Flippy1212/Lernecken/Bilder/Sensor_weitwinkel.jpg

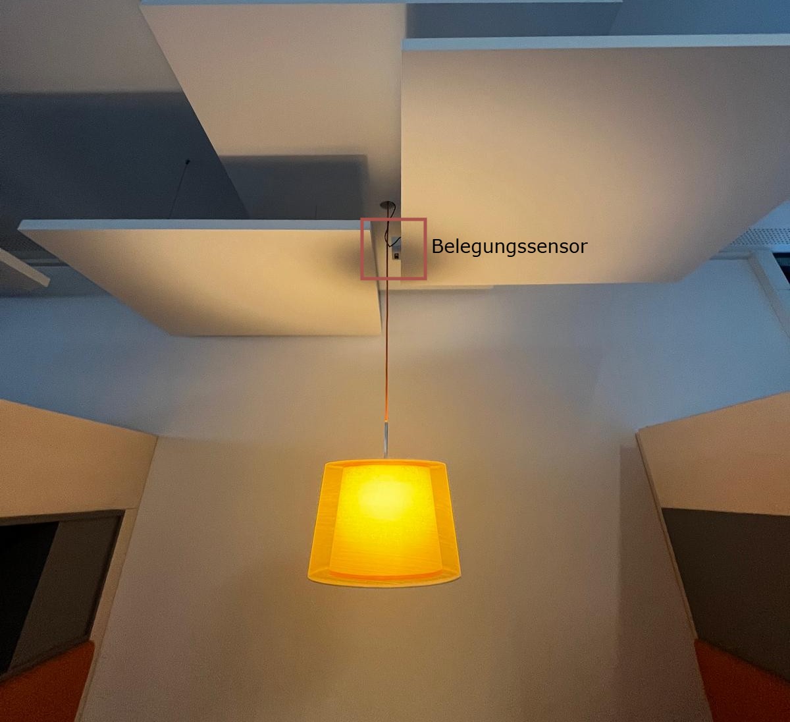
Bilder/Sensor_weitwinkel.jpg
