Flippy1212/Lernecken/Bilder/belegungserkennung_zustandsdiagramm_v12.png

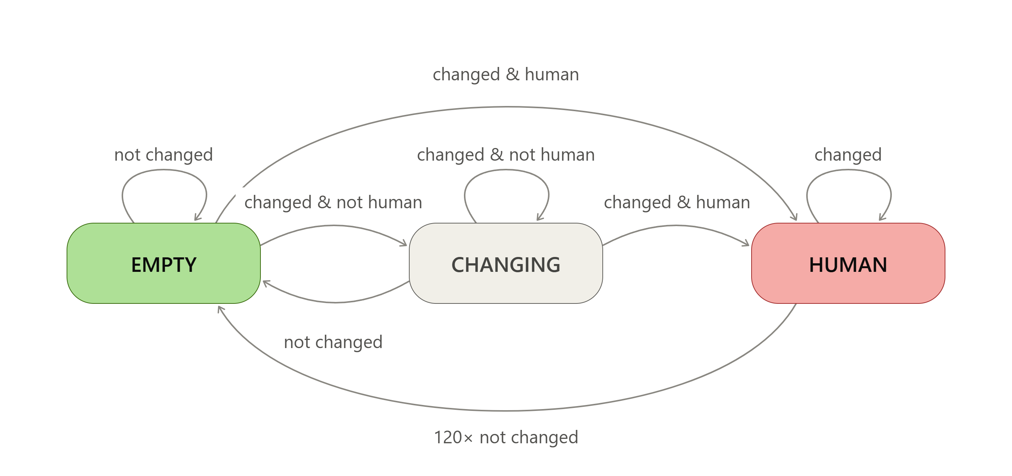
Bilder/belegungserkennung_zustandsdiagramm_v12.png
