Flippy1212/Lernecken/Bilder/heltec_v3_amg8833_verdrahtung.jpg

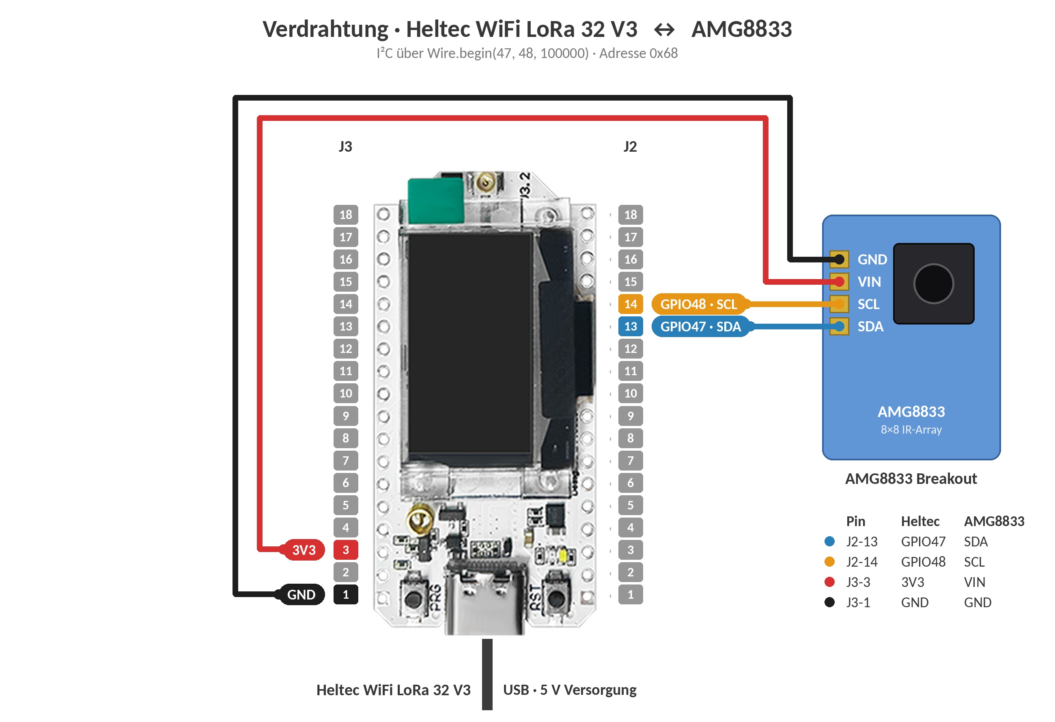
Bilder/heltec_v3_amg8833_verdrahtung.jpg
