Flippy1212/Lernecken/Lerneckenbox/Box.3mf

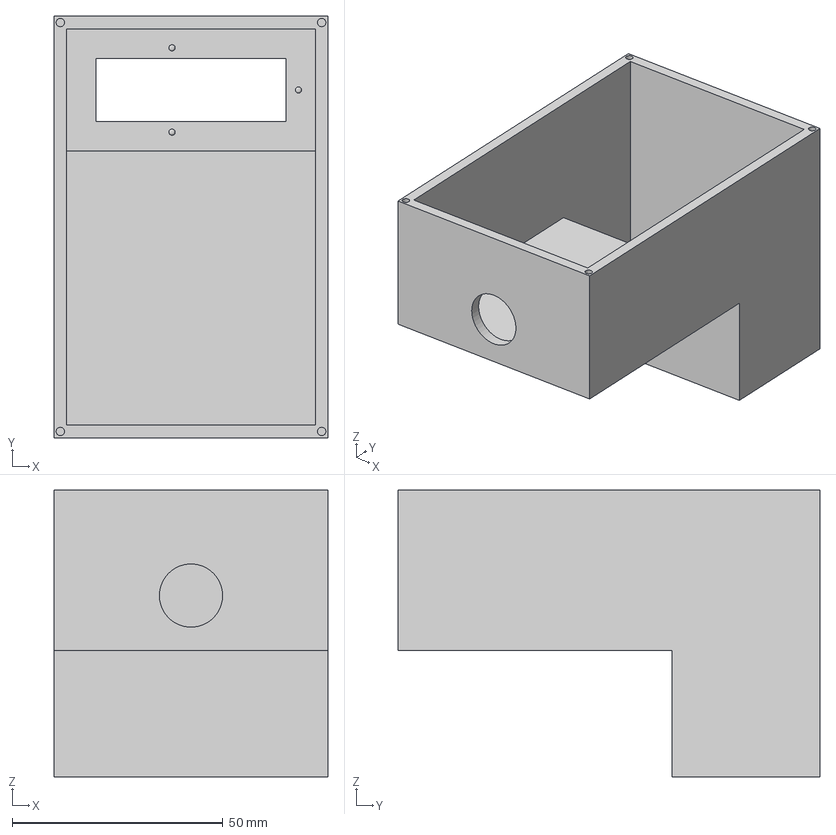
[picture p10: CAD file, 2026-10-15]
Lerneckenbox/Box.3mf
65.0 x 100.0 x 68.0 mm
