Flippy1212/Lernecken/Lerneckenbox/Lerneckenbox.step

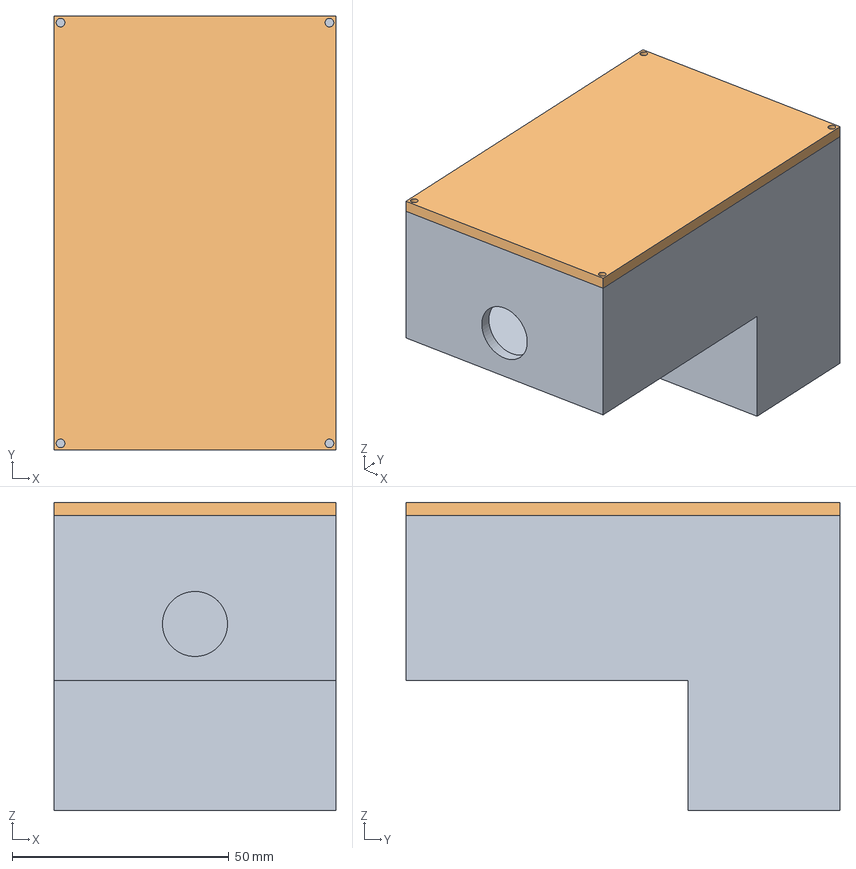
[picture p11: CAD file, 2026-10-15]
Lerneckenbox/Lerneckenbox.step
65.0 x 100.0 x 71.0 mm
