Flippy1212/Lernecken/Lerneckenbox/Deckel.3mf

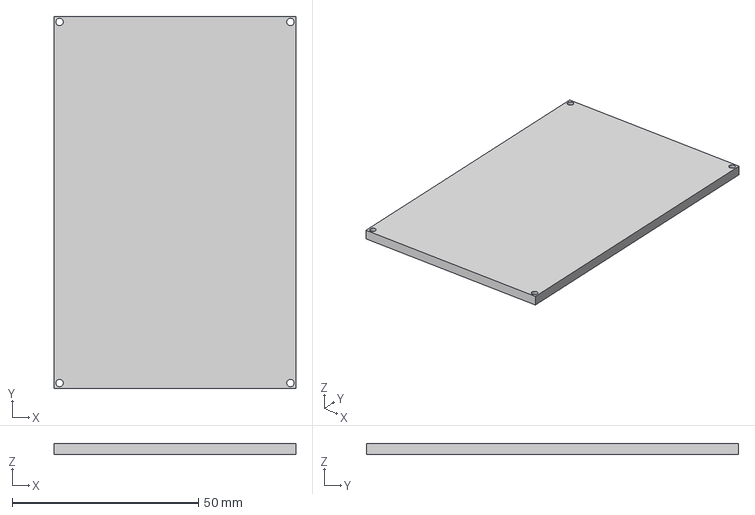
[picture p12: CAD file, 2026-10-15]
Lerneckenbox/Deckel.3mf
65.0 x 100.0 x 3.00 mm
