Flippy1212/Lernecken/(commit log)

2026-10-14 updated wiring diagram
2026-10-14 dont track nacharbeit
